abarriuso/igneus-v2-et4-4010-led/README.md

# Igneus V2 for the Anet ET4 — 4010 blowers and LED light

**[Website with the interactive 3D visualizer](https://abarriuso.github.io/igneus-v2-et4-4010-led/)** ·
**[Part generator](https://abarriuso.github.io/igneus-v2-et4-4010-led/generator/)**: enter your measurements and download the STL
(or open `cad-studio/parts/customizer.scad` in OpenSCAD's Customizer)

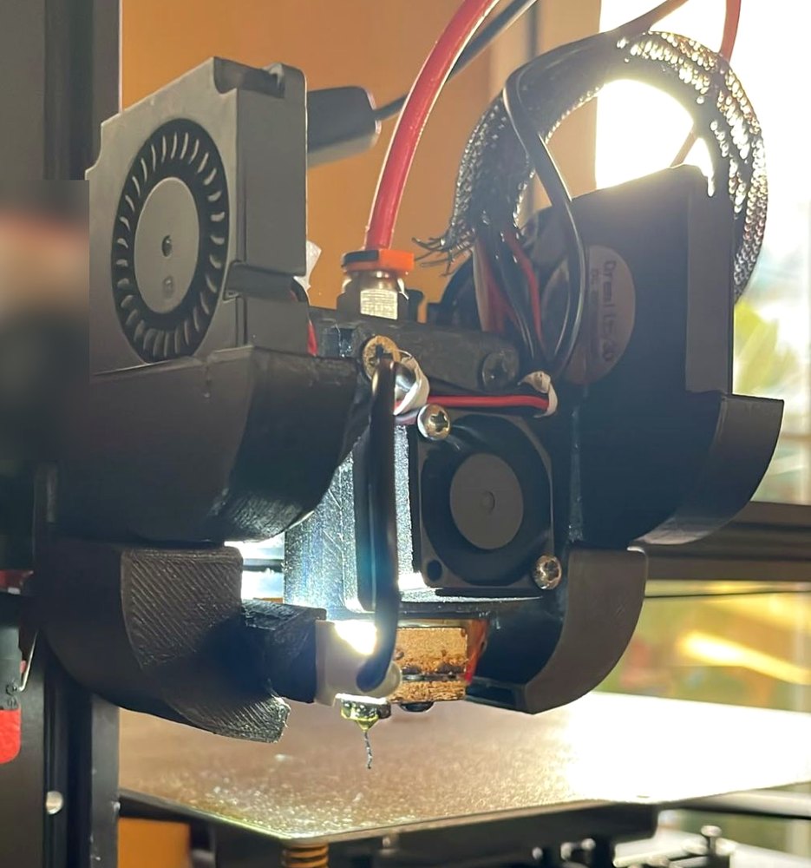
[picture p1: screenshots/real_build.jpg]
The remix printed and running on an Anet ET4, with the LEDs lighting the nozzle


*Printed and running on an Anet ET4, with the LEDs lighting the nozzle.*

**Remix of [IGNEUS V2 - E3D V6/VOLCANO - ANET ET4 / ET4 PRO / ET4X / ET5](https://www.thingiverse.com/thing:4178590) by Locos3D**,
licensed under [Creative Commons BY-NC-SA 4.0](https://creativecommons.org/licenses/by-nc-sa/4.0/), like the original.

## What this remix adds

- **4010 adapter** to fit the Ender 3's stock 4010 blowers to the original 5015 ducts, in two versions:
  - **Normal**: the blower stands in the original position, push-fitted in the cradle; the adapter plugs into the
    duct and is screwed to the duct's ear.
  - **Flat**: the blower sits on top of the adapter with its intake facing the front, like the hotend fan.
    The adapter is only 15 mm tall, so the blowers sit low.
- **LED mount** that fits on the inside of each original duct, held with a zip tie, and aims two LEDs of a
  24 V LED strip with one lensed LED per segment, like the light strips sold for the Bambu Lab A1, at the nozzle.
- **One-piece duct**, in both versions, if you prefer to reprint the ducts: duct, fan cradle, mounting arm and
  LED channel drawn as a single part with rounded, flowing lines, not the adapter stuck onto the original duct.
  It keeps the original's rails, height slot and air channel, so it mounts and aims the air the same way.
- **25 → 30 mm fan adapter** so the 2510 hotend fan of an Anycubic Kobra X fits Locos3D's 30 mm fan clamp.

| Normal | Flat |
|---|---|
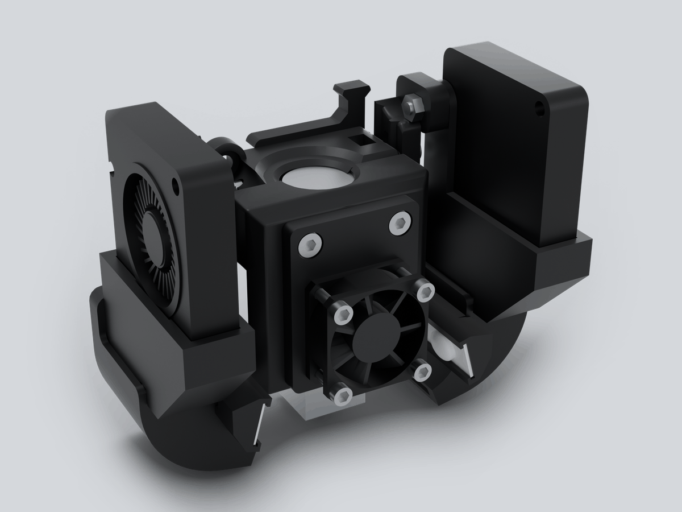
[picture p2: screenshots/assembly_normal.png]
Normal version, assembled
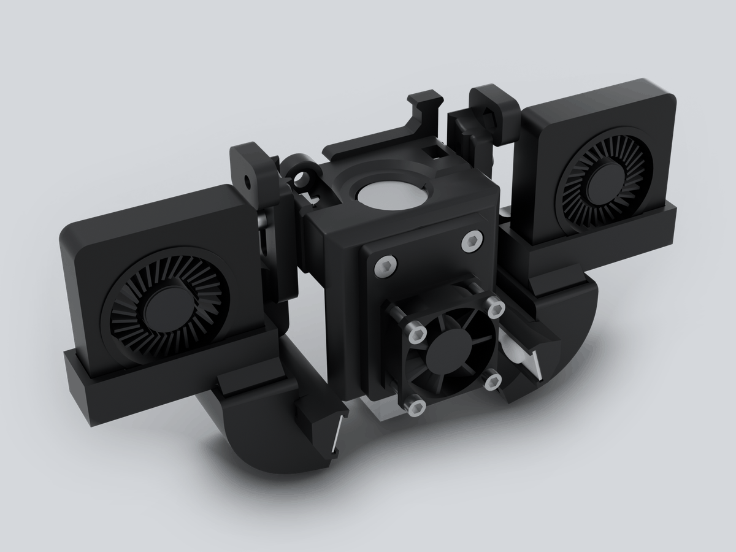
[picture p3: screenshots/assembly_flat.png]
Flat version, assembled
|  |  |
| **One-piece, normal** | **One-piece, flat** |
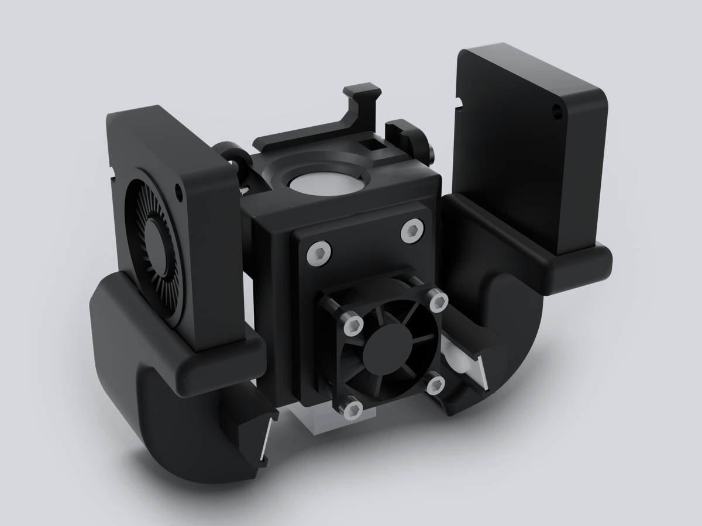
[picture p4: screenshots/assembly_onepiece.png]
One-piece ducts, normal version, assembled
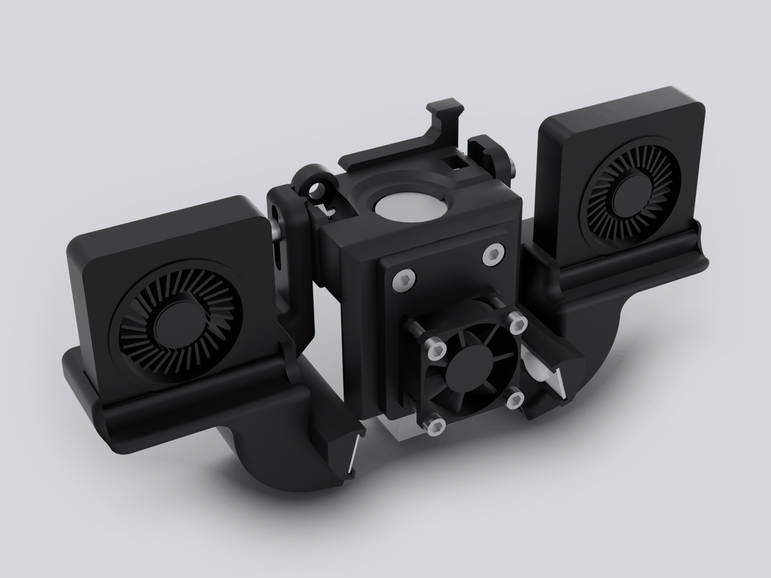
[picture p5: screenshots/assembly_onepiece_flat.png]
One-piece ducts, flat version, assembled
|  |  |

Renders made in Blender from the CAD models (`cad-studio/tools/render_site.py`).

## Downloads

All files are oriented for printing and **none of them needs supports**: every overhang is 45° or steeper and
the few flat ceilings left are short bridges between two walls. Right and left parts are mirror images.

| | Part | Download | Printing |
|---|---|---|---|
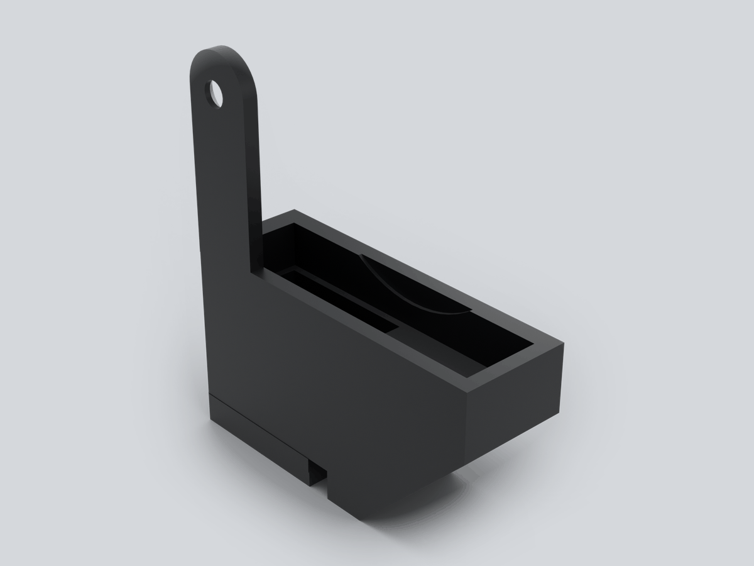
[picture p6: screenshots/part_adapter_4010.png]
|  | 4010 adapter, normal | [right](cad-studio/export/Adapter_4010_right.stl) · [left](cad-studio/export/Adapter_4010_left.stl) | Nozzle down, no supports |
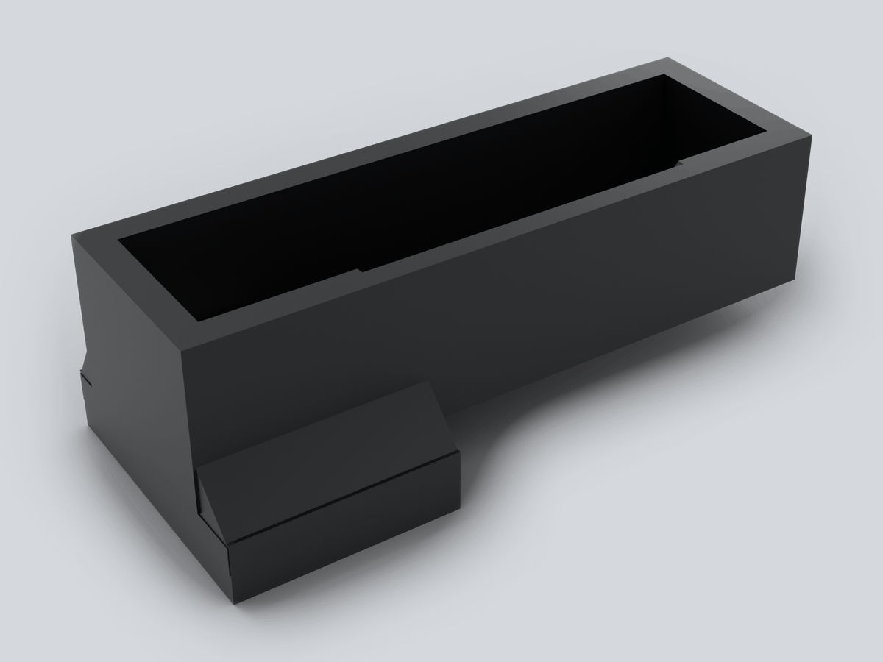
[picture p7: screenshots/part_adapter_4010_flat.png]
|  | 4010 adapter, flat | [right](cad-studio/export/Adapter_4010_flat_right.stl) · [left](cad-studio/export/Adapter_4010_flat_left.stl) | Upside down, no supports |
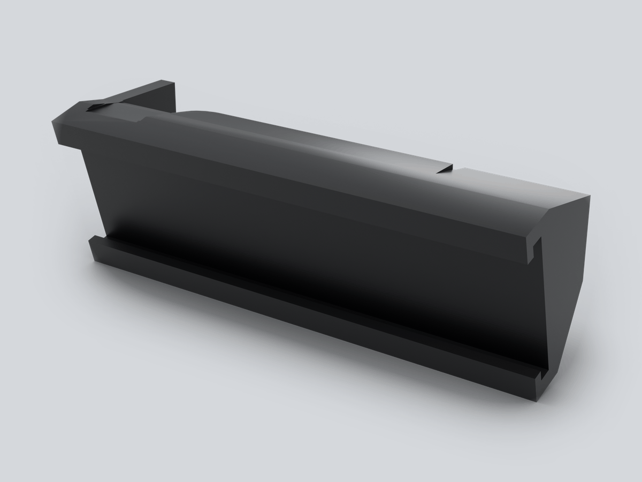
[picture p8: screenshots/part_led_mount.png]
|  | LED mount for the original duct | [right](cad-studio/export/LED_mount_right.stl) · [left](cad-studio/export/LED_mount_left.stl) | No supports |
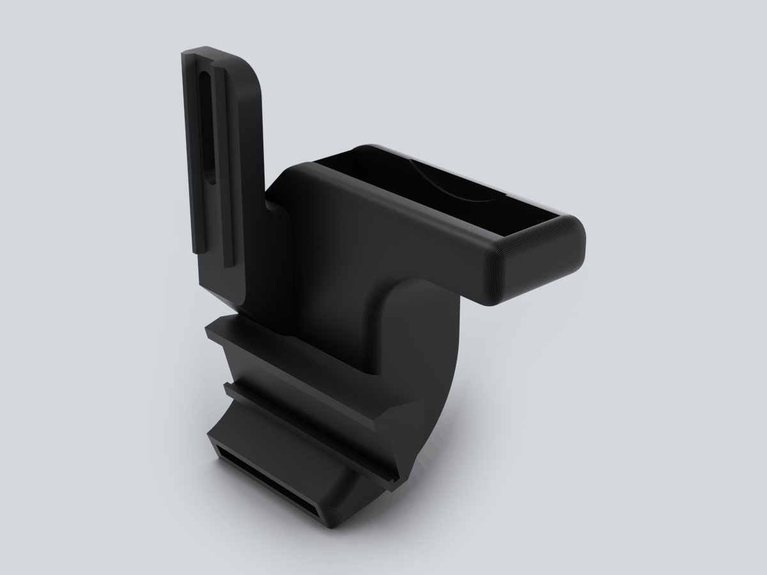
[picture p9: screenshots/part_duct_4010_led.png]
|  | One-piece duct with LED channel, normal | [right](cad-studio/export/Duct_4010_LED_right.stl) · [left](cad-studio/export/Duct_4010_LED_left.stl) | On its flat back face, no supports |
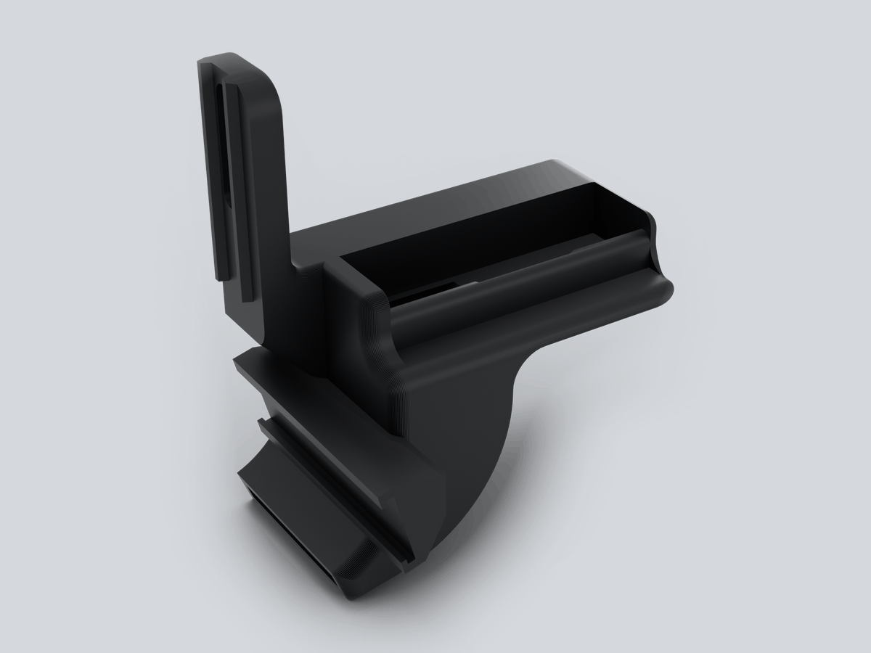
[picture p10: screenshots/part_duct_4010_led_flat.png]
|  | One-piece duct with LED channel, flat | [right](cad-studio/export/Duct_4010_LED_flat_right.stl) · [left](cad-studio/export/Duct_4010_LED_flat_left.stl) | On its flat back face, no supports (the low front wall of the cradle prints as a bridge) |
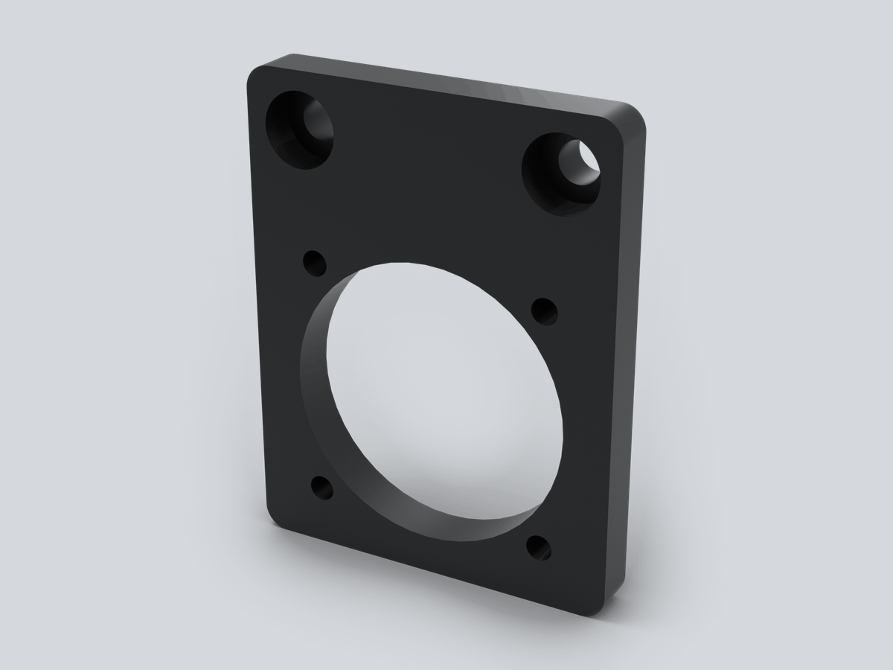
[picture p11: screenshots/part_fan_adapter_2510_30.png]
|  | 2510 fan to the 30 mm fan clamp | [download](cad-studio/export/Fan_adapter_2510_30mm.stl) | Fan side down, no supports |

## Printing

- **Material: PETG, ASA or ABS.** The ducts and adapters end a few millimetres from the heater block and the hot
  nozzle: PLA softens there and the ducts sag.
- **Settings** that suit these parts: 0.4 mm nozzle, 0.2 mm layers, 3–4 walls, 20–40 % infill. The duct walls are
  1.5–3 mm thick, so with 3–4 walls they print solid.
- **No supports**, in the orientation of the files.
- **Brim** on the two tall, narrow parts: the normal 4010 adapter (51 mm tall, standing on its nozzle) and the
  LED mount (39 mm tall on a 12 × 13 mm footprint).

## Hardware

Per side (right and left), depending on the version you build:

| Part | Hardware |
|---|---|
| Every version | 4010 blower, 24 V (the Ender 3's stock part-cooling fan) |
| Original or one-piece duct | M3 × 14 socket head screw and M3 nut, through the height slot into the body's nut pocket |
| 4010 adapter, normal | M3 × 10 countersunk screw and M3 nut, through the adapter's arm and the duct's ear. The blower is push-fitted in the cradle, no screws |
| 4010 adapter, flat | None: the cradle holds the blower |
| LED mount | A small zip tie, up to 3.2 mm wide and 1.4 mm thick |
| LEDs | 2 LEDs of a 24 V strip with one lensed LED per segment (10 mm wide, cut marks 18.1 mm apart) |

For the **2510 fan adapter** (one, on the front clamp): the clamp's two M3 screws, about **4 mm longer** than without
it (M3 × 24 in place of M3 × 20), and 4 self-tapping **M2.5 × 12** screws for the fan.

## Assembly notes

- **Blowers**: wire both 4010 blowers in parallel to the printer's part-cooling fan output, so they always run at
  the same speed.
- **LEDs**: on this kind of strip each LED is its own segment. Cut it at the marks, two LEDs per side, and wire both
  pieces in parallel to 24 V.
- **2510 fan adapter**: it is held by the clamp's own two M3 screws, and the fan is fixed to it with the 4 self-tapping
  M2.5 screws.

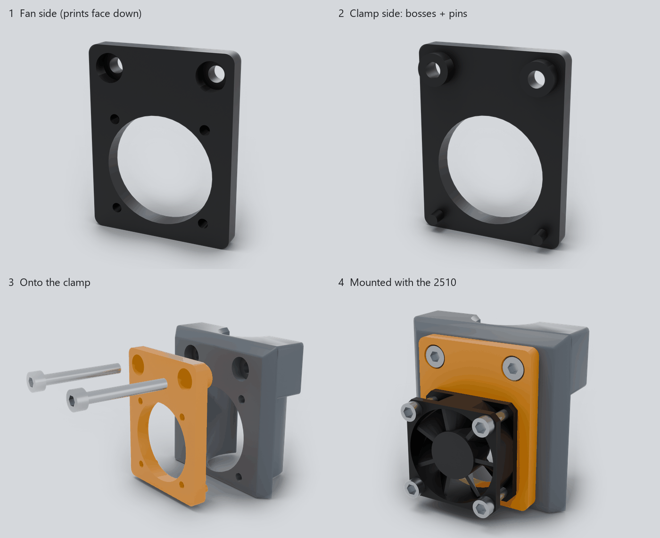
[picture p12: screenshots/fan_adapter_2510_30.png]
2510 fan adapter


## Original parts

Everything else is Locos3D's original Igneus V2: **[download it from Thingiverse](https://www.thingiverse.com/thing:4178590)**
([assembly guide](https://cults3d.com/en/3d-model/various/igneus-mounting-guide-on-anet-et4-et5)). This build uses:

| File | Qty | What it is |
|---|---|---|
| `Igneus_Version1_Rev.3.stl` | 1 | Body for the E3D V6 |
| `Abrazadera_Adapter_Fan_30mm.stl` | 1 | Front clamp with the 30 mm fan mount |
| `Tobera_5015_V2.stl` | 2 | 5015 duct, one of them mirrored for the left side (not needed with the one-piece ducts) |

## Rebuilding the files

The parts are OpenSCAD sources in `cad-studio/parts/` (libraries in `parts/lib/`), and everything published is
generated from them.

1. Install [OpenSCAD](https://openscad.org/) and Python 3 with `numpy` (plus `trimesh`, `Pillow` and Blender, only
   for the renders).
2. Download Locos3D's Igneus V2 pack, copy the three files listed in [`cad-studio/igneus/README.md`](cad-studio/igneus/README.md)
   into that folder and run `python tools/place_originals.py` from `cad-studio/`.
3. From `cad-studio/`, run `python tools/build_all.py`. It builds every part, then refreshes the print-ready STLs in
   `export/` and the visualizer pages in `visualizer/`. A file is only rewritten when its geometry changed, so
   rebuilding unchanged sources leaves git clean. Add `--renders` to re-render `screenshots/` in Blender.

While you edit, `python server.py` (in `cad-studio/`) serves a live viewer at http://localhost:8765 that rebuilds
each part when you save it.

## License

Remix of IGNEUS V2 by [Locos3D](https://www.thingiverse.com/thing:4178590), shared under
[CC BY-NC-SA 4.0](https://creativecommons.org/licenses/by-nc-sa/4.0/): credit Locos3D, non-commercial use only,
and share any derivative under the same license. The full license text is in [LICENSE](LICENSE).
