abarriuso/igneus-v2-et4-4010-led/generator/originals/README.md

# Original parts used by the generator

`duct_5015.stl` is Locos3D's `Tobera_5015_V2.stl` from [IGNEUS V2](https://www.thingiverse.com/thing:4178590), only
moved to where it sits on the printer so the generator can carve the LED mount against it. The other parts are
drawn from scratch and don't need it.

It is shared under the original license, [CC BY-NC-SA 4.0](https://creativecommons.org/licenses/by-nc-sa/4.0/):
credit Locos3D, non-commercial use only, share alike.
