abarriuso/igneus-v2-et4-4010-led/cad-studio/export/Duct_4010_LED_left.stl

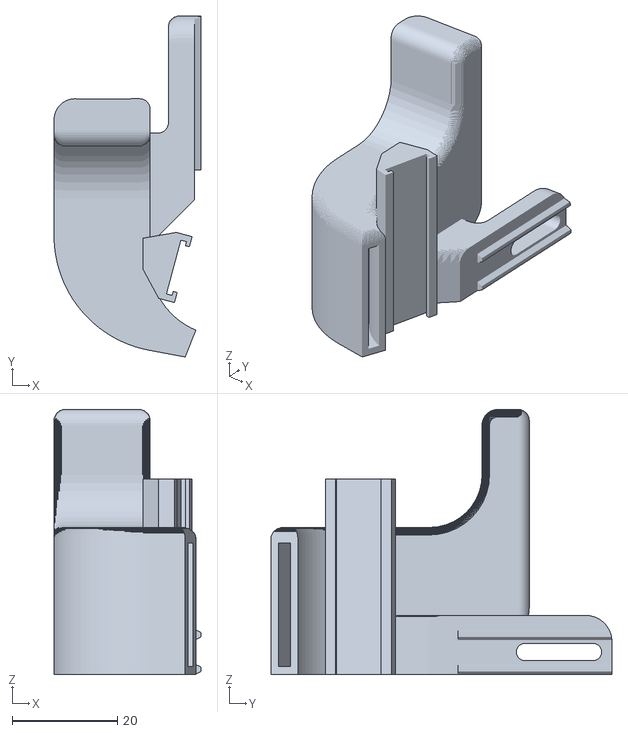
[picture p13: CAD file, 2026-11-07]
cad-studio/export/Duct_4010_LED_left.stl
28.0 x 64.9 x 50.5
