abarriuso/igneus-v2-et4-4010-led/generator/originals/duct_5015.stl

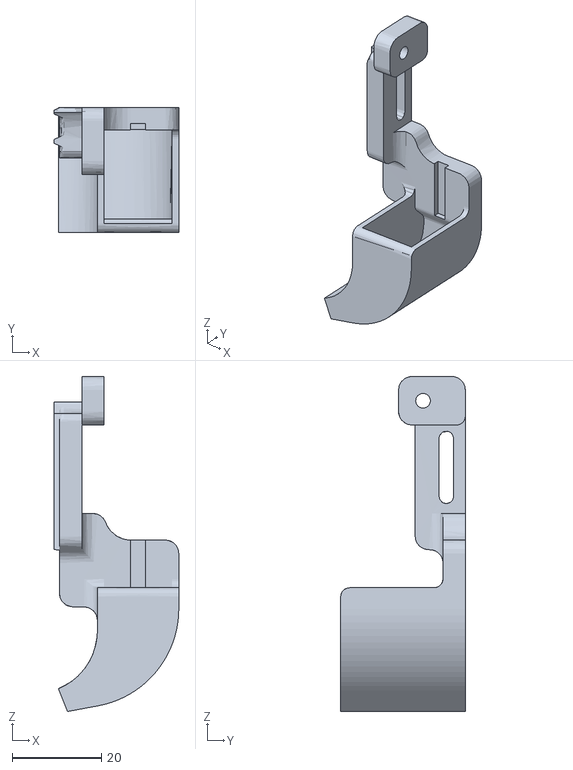
[picture p14: CAD file, 2026-10-13]
generator/originals/duct_5015.stl
28.0 x 28.0 x 75.2
