abarriuso/igneus-v2-et4-4010-led/cad-studio/export/Duct_4010_LED_flat_right.stl

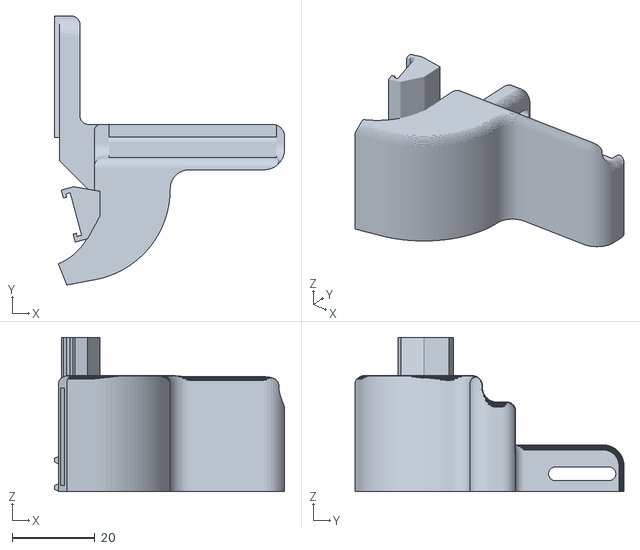
[picture p15: CAD file, 2026-11-07]
cad-studio/export/Duct_4010_LED_flat_right.stl
55.6 x 64.9 x 37.2
