abarriuso/igneus-v2-et4-4010-led/cad-studio/export/Adapter_4010_flat_right.stl

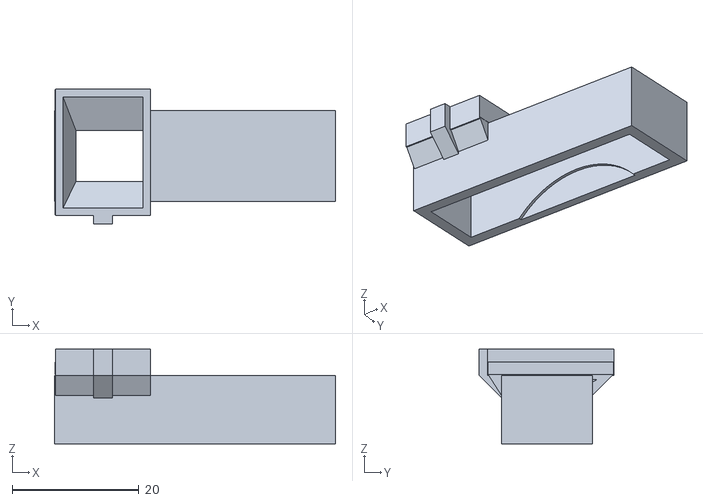
[picture p16: CAD file, 2026-11-07]
cad-studio/export/Adapter_4010_flat_right.stl
44.4 x 21.3 x 15.0
