abarriuso/igneus-v2-et4-4010-led/cad-studio/export/Adapter_4010_left.stl

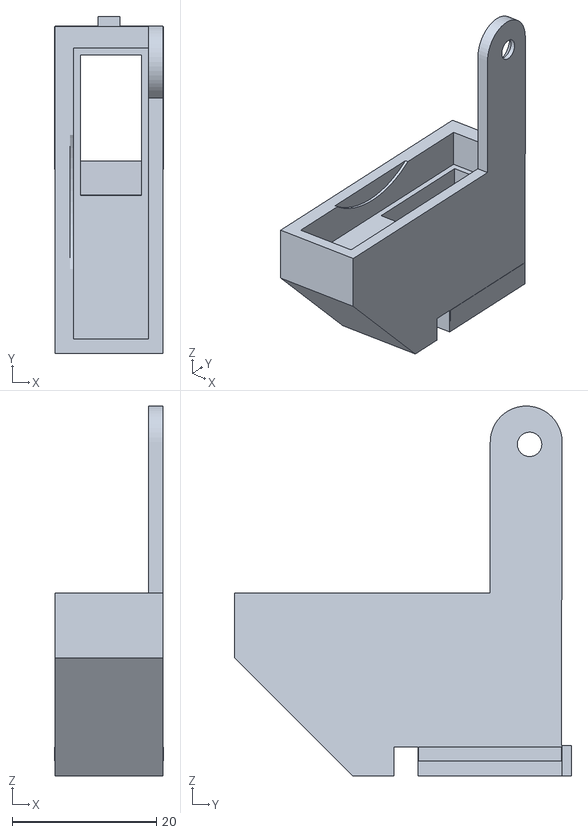
[picture p17: CAD file, 2026-11-07]
cad-studio/export/Adapter_4010_left.stl
15.1 x 46.8 x 51.3
