abarriuso/igneus-v2-et4-4010-led/cad-studio/export/LED_mount_right.stl

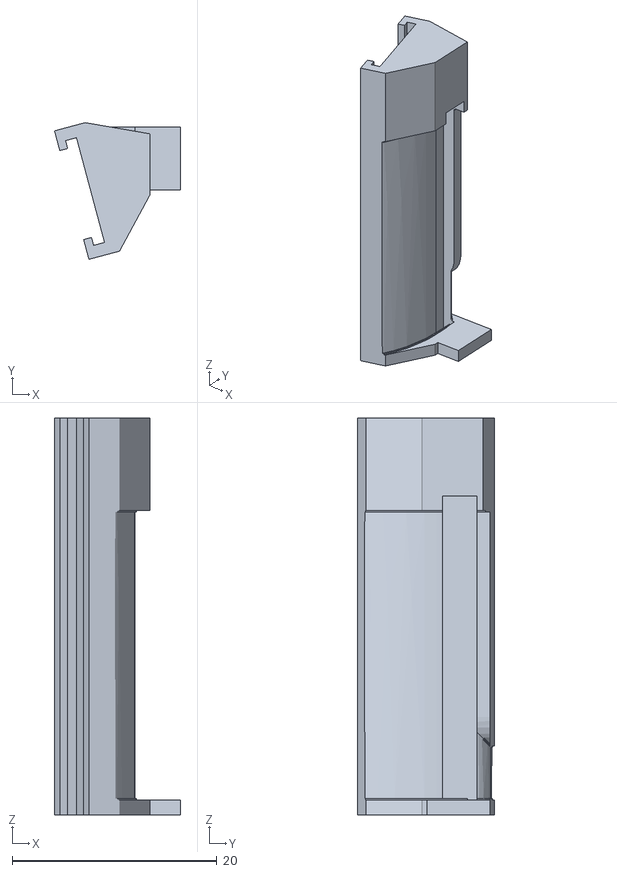
[picture p18: CAD file, 2026-10-13]
cad-studio/export/LED_mount_right.stl
12.3 x 13.4 x 38.8
