abarriuso/igneus-v2-et4-4010-led/cad-studio/export/Fan_adapter_2510_30mm.stl

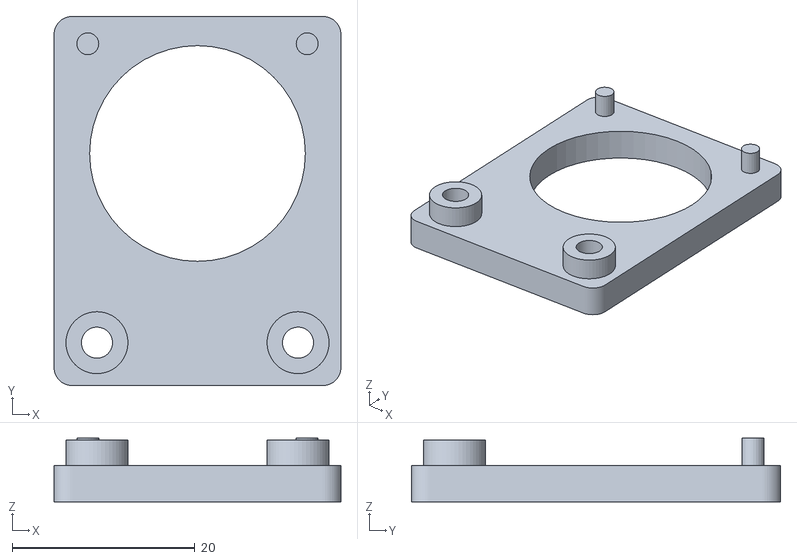
[picture p19: CAD file, 2026-10-13]
cad-studio/export/Fan_adapter_2510_30mm.stl
31.4 x 40.4 x 7.00
