abarriuso/igneus-v2-et4-4010-led/cad-studio/parts/adapter_4010_right.scad

// color: #1d1d1f
// variant: normal
// 4010 adapter — right side (as mounted)
include <lib/duct4010.scad>

translate([36.05, 0, 0]) adapter4010();
