abarriuso/igneus-v2-et4-4010-led/cad-studio/parts/duct_4010_flat_left.scad

// color: #1d1d1f
// variant: onepiece_flat
// One-piece 4010 duct, flat version (blower on top, intake to the front), left side (as mounted).
include <lib/flat4010.scad>

translate([-36.05, 0, 0]) mirror([1, 0, 0]) duct4010_flat();
