abarriuso/igneus-v2-et4-4010-led/cad-studio/parts/duct_4010_right.scad

// color: #1d1d1f
// variant: onepiece
// One-piece 4010 duct with the LED channel, right side (as mounted). Replaces the original 5015 duct and the adapter.
include <lib/duct4010.scad>

translate([36.05, 0, 0]) duct4010();
