abarriuso/igneus-v2-et4-4010-led/cad-studio/parts/led_mount_right.scad

// color: #1d1d1f
// variant: normal flat
// LED mount for the original duct — right side (as mounted)
include <lib/duct4010.scad>

translate([36.05, 0, 0]) led_mount();
