abarriuso/igneus-v2-et4-4010-led/cad-studio/parts/view_clamp_30.scad

// color: #1d1d1f
// PREVIEW ONLY: front clamp with 30 mm fan mount (original Igneus part).
import("../igneus/view/clamp_fan30.stl", convexity = 6);
