abarriuso/igneus-v2-et4-4010-led/cad-studio/parts/view_fan_2510_rotor.scad

// color: #2a2a2d
// PREVIEW ONLY: 2510 rotor (spins in the animation; axis = Y through x 0, z -5.05).
include <lib/fans.scad>

translate([0, -27.06 - 4.0 - 10, -5.05]) rotate([-90, 0, 0]) axial_2510_rotor();
