abarriuso/igneus-v2-et4-4010-led/cad-studio/parts/view_igneus_body.scad

// color: #1d1d1f
// PREVIEW ONLY: Igneus V1 body (E3D V6) in place. Not printed from here.
import("../igneus/view/body_v1_v6.stl", convexity = 6);
