abarriuso/igneus-v2-et4-4010-led/cad-studio/parts/view_original_ducts.scad

// color: #1d1d1f
// variant: normal flat
// PREVIEW ONLY: your original 5015 ducts (the ones you already have printed).
import("../igneus/view/original_ducts.stl", convexity = 6);
