abarriuso/igneus-v2-et4-4010-led/cad-studio/parts/view_v6_heater_block.scad

// color: #b9bec5
// material: metal
// PREVIEW ONLY: E3D V6 heater block (aluminium).
include <lib/v6.scad>
v6_heater_block();
