abarriuso/igneus-v2-et4-4010-led/cad-studio/parts/view_v6_heater_cartridge.scad

// color: #8f949a
// material: metal
// PREVIEW ONLY: heater cartridge and thermistor.
include <lib/v6.scad>
v6_heater_cartridge();
