abarriuso/igneus-v2-et4-4010-led/cad-studio/parts/view_v6_heatsink.scad

// color: #cfd3d8
// material: metal
// PREVIEW ONLY: E3D V6 heatsink (aluminium).
include <lib/v6.scad>
v6_heatsink();
