abarriuso/igneus-v2-et4-4010-led/cad-studio/parts/view_v6_nozzle.scad

// color: #d6ab4a
// material: metal
// PREVIEW ONLY: brass nozzle.
include <lib/v6.scad>
v6_nozzle();
