abarriuso/igneus-v2-et4-4010-led/(list of files, cad)

Other CAD files:
cad-studio/export/Duct_4010_LED_flat_left.stl
cad-studio/export/Duct_4010_LED_right.stl
cad-studio/export/Adapter_4010_flat_left.stl
cad-studio/export/Adapter_4010_right.stl
cad-studio/export/LED_mount_left.stl
cad-studio/parts/adapter_4010_flat_right.scad
cad-studio/parts/duct_4010_flat_right.scad
cad-studio/parts/led_mount_left.scad
cad-studio/parts/view_nuts_flat.scad
cad-studio/parts/view_screws_flat.scad
