abarriuso/igneus-v2-et4-4010-led/(commit log)

2026-10-13 Igneus V2 for the Anet ET4: 4010 blowers and LED light
    Remix of IGNEUS V2 by Locos3D (CC BY-NC-SA 4.0), thing:4178590.
    4010 adapter (normal and flat versions), LED mount, one-piece ducts with
    the LED channel, 25 -> 30 mm fan adapter, OpenSCAD sources, live viewer
    and the assembly animation tools.
    [Adapter_4010_flat_left.stl, Adapter_4010_flat_right.stl, Adapter_4010_left.stl, Adapter_4010_right.stl, Duct_4010_LED_flat_left.stl, Duct_4010_LED_flat_right.stl, Duct_4010_LED_left.stl, Duct_4010_LED_right.stl]
2026-11-07 Support-free parts and a true one-piece duct
    - One-piece ducts (normal and flat) drawn from scratch as a single part
    (parts/lib/duct_body.scad): air channel, mounting rails and height slot
    measured from Locos3D's 5015 duct, fan cradle and LED channel built in.
    They print on their flat back face without supports.
    - 4010 adapter (normal) redesigned to print nozzle down without supports;
    flat adapter overhangs removed. Both are parametric now and no longer
    need the original adapter mesh.
    - Relief in the cradles for the ring round the blower intake.
    - Viewer: parts can belong to several variants; One-piece buttons.
    - Visualizer: one-piece animations and tabs; charset fix.
    - New print e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
    [Adapter_4010_flat_left.stl, Adapter_4010_flat_right.stl, Adapter_4010_left.stl, Adapter_4010_right.stl, Duct_4010_LED_flat_left.stl, Duct_4010_LED_flat_right.stl, Duct_4010_LED_left.stl, Duct_4010_LED_right.stl]
2026-11-07 Rounded one-piece ducts and Blender renders for the site
    - One-piece ducts, normal and flat: every edge rounded, the duct walls run
    straight up into the cradle, the cradle sweeps out on a wide fillet and the
    spine curves into the duct wall. Still support-free in the same orientation,
    same fit, same bridges.
    - All site and README images are now Cycles renders made from the CAD models
    (tools/render_site.py + tools/render_blender.py), at 4:3 on the card colour.
    - Re-exported the one-piece STLs and re-packed their 3D animations.
    [Duct_4010_LED_flat_left.stl, Duct_4010_LED_flat_right.stl, Duct_4010_LED_left.stl, Duct_4010_LED_right.stl]
2026-11-08 License, printing and hardware docs, and a one-command build
    - LICENSE: the CC BY-NC-SA 4.0 legal code, so GitHub shows the license.
    - README and site: printing (material, settings, brim), hardware for each
    version, blower wiring, and how to rebuild the files.
    - tools/build_all.py: builds every part, refreshes export/ and the
    visualizer pages, and only rewrites a file when its geometry changed.
    - Visualizer: doctype and viewport in the animation template, so the pages
    render in standards mode and lay out properly on phones; pages regenerated.
